mariosgit/freeDSPx-AMP-x4/README.md

# freeDSPx AMP x4

BOARD STATUS: READY TO BE BUILT

MAIN COORDINATOR: [ssMMnn](https://github.com/ssMMnn)

Multichannel Class-D amplification module with digital input, designed for use with the freeDSP. Based on TI's TAS5720M chip. Supports freeDSP standard I2S expansion connector. Supports TDM input format.

[Read the docu...](./freeDSPx%20AMP%20x4.md)

## License

This work and all other materials under https://github.com/freeDSP are licensed under a <a rel="license" href="http://creativecommons.org/licenses/by-sa/4.0/legalcode">Creative Commons Attribution Share-Alike 4.0 license</a>. This allows for both personal and commercial derivative works, as long as they credit freeDSP and release their designs under the same license.
