mariosgit/freeDSPx-AMP-x4/freeDSPx AMP x4.md

# 	

Exported from google docs, vscode md preview does show the embedded images.

# 

**Getting started**   
**with the freeDSPx AMP x4**

**Revision history**

| Revision | Description | Date |
| :---- | :---- | :---- |
| V 1.0 | Initial version | 26 Feb 2017 |
|  |  |  |
|  |  |  |
|  |  |  |

**Table of contents**

[About the freeDSPx AMP x4](#about-the-freedspx-amp-x4)

[Important information](#important-information)

[Overview](#overview)

[Output power](#output-power)

[Digital input](#digital-input)

[LEDs and fault states](#leds-and-fault-states)

[How to get the freeDSPx AMP x4 up and running](#how-to-get-the-freedspx-amp-x4-up-and-running)

[Get everything needed](#get-everything-needed)

[Solder the board](#solder-the-board)

[Setting-up operation](#setting-up-operation)

[Troubleshooting](#troubleshooting)

[Appendix](#appendix)

[Specifications](#specifications)

[Part list](#part-list)

[Assembly print](#assembly-print)

[Schematic](#schematic)

# **About the freeDSPx AMP x4** {#about-the-freedspx-amp-x4}

The freeDSPx AMP x4 is a four channel amplifier module with a digital eight channel TDM input, designed to be used with a freeDSP module. The freeDSPx AMP x4 is a medium power class-D amplifier based on the TAS5720M IC from Texas Instruments and can supply up to 25 Watts with less than 1% THD+N to a 4Ω load per channel. The amplifier directly uses a digital input signal and circumvents an additional digital to analog conversion after the DSP. Overall noise and signal to noise ratio will be improved through that. Two freeDSPx AMP x4 can be stacked to form an eight channel amplifier.

The plans for the freeDSP boards are published under a Creative Commons Attribution Share-Alike 4.0 license, which allows the unrestricted use and modification of the module.  This means that experienced users can make their own version of the module, extending it and improving it, as long as they credit freeDSP and release their designs under the same license. The freeDSP brand and freeDSP logo are copyright of Sebastian Merchel and Ludwig Kormann and cannot be used without formal permission. This getting started guide is published under the same CC license. 

# **Important information**  {#important-information}

Boards from the freeDSP system are provided to you ‘as is’. We make no express or implied warranties whatsoever with respect to its functionality, operability, or use, including, without limitation, any implied warranties of merchantability, fitness for a particular purpose, or infringement. We expressly disclaim any liability whatsoever for any direct, indirect, consequential, incidental or special damages, including, without limitation, lost revenues, lost profits, losses resulting from business interruption or loss of data regardless of the form of action or legal theory under which the liability may be asserted, even if advised of the possibility or likelihood of such damages. Features and specifications might change without prior notice.

**Please keep in mind that freeDSP is an open-source spare-time project.** Because the freeDSP system is very flexible, many applications are possible. Questions and new ideas can be discussed online with other DIYers.  Please use the ‘Digital Line Level’ subforum @ diyAudio.com to connect with other people working with the freeDSP. Please create individual threads for your topics. Link these threads in the [**freeDSP main thread**](http://www.diyaudio.com/forums/digital-line-level/285260-freedsp-main-thread.html) \- so that others can find them. Some questions can be answered by carefully reading this manual. **We cannot provide individual support via email.** Thank you for your understanding\!

# **Overview** {#overview}

Figure 1 shows the key features of the freeDSPx AMP x4 board. 



**Figure 1 \- Overview of the freeDSPx AMP x4 board**

## **Output power** {#output-power}

The maximum output power of the freeDSPx AMP x4 depends on the load impedance and the supply voltage. An increase of the supply voltage up to 18 V will lead to increased output power. Further increase in the supply voltage up to 26,4 V is possible but will not lead to more output power. The output power of the freeDSPx AMP x4 is shown in Table 1\.

**Table 1 – Output power of the freeDSPx AMP x4**

| Power supply  | Load Impedance | Maximum THD+N | Output power |
| :---- | :---- | :---- | :---- |
| 12 V | 4 | 0,1 % | 11,9 W |
| 12 V | 4 | 1 % | 12,6 W |
| 12 V | 8 | 0,1 % | 7,1 W |
| 12 V | 8 | 1 % | 7,4 W |
| 18 V or more | 4 | 0,1 % | 14,0 W |
| 18 V or more | 4 | 1 % | 25,0 W |
| 18 V or more | 8 | 0,1 % | 13,1 W |
| 18 V or more | 8 | 1 % | 13,8 W |

## **Digital input** {#digital-input}

The freeDSPx AMP x4 features an digital eight channel time division multiplexed (TDM) input. The amplifier can use the lower (0-3) or upper (4-7) four slots of a TDM-8 frame as input. The input slots can be selected with the TDM slot jumper. You can use a ribbon cable and crimp multiple connectors on it, to connect two freeDSPx AMP x4 to a single TDM output of a freeDSP and amplify all eight channels. 

For more details on TDM and digital audio communication with the freeDSP system refer to the freeDSP \- serial audio getting started guide.

## **LEDs and fault states**  {#leds-and-fault-states}

The freeDSPx AMP x4 has a green power led (D4) which indicates that the amplifier is powered. The module also has four red fault leds (D5, D6, D7, D8) which indicate a fault state on the closest amplifier IC to the led. Reasons for faults  states can be:

1) no correct digital TDM signal at the input  
2) overtemperature of the amplifier IC  
3) overcurrent or short circuit at the output  
4) over- or undervoltage at the power supply  

When a fault state occurs the amplifier will mute the corresponding output. The output will be automatically unmuted pop-free after the fault state is no longer present.

# **How to get the freeDSPx AMP x4 up and running** {#how-to-get-the-freedspx-amp-x4-up-and-running}

The following steps will guide you through the workflow to get your freeDSPx AMP x4 up and running. 

## **Get everything needed** {#get-everything-needed}

You need all electronic components and a printed circuit board (pcb) to build your freeDSPx AMP x4. A bill of materials for the components is listed at the end of this document. The manufacturing data (gerber) as well as the schematic and layout (KiCAD) for the pcb is available on the freeDSP GitHub. 

If you group together with friends or others and order pbs and components in bulk, you can save money. 

## **Solder the board**  {#solder-the-board}

All surface mounted devices of the freeDSPx AMP x4 have to be soldered in a reflow process. The solder paste should be stencil printed. The manufacturing data for a stencil is also available on the freeDSP GitHub. Keep in mind that the TAS5720M amplifier IC is a fine-pitch component in a QFN package with 0,4 mm pitch and will require sufficient precision in the manufacturing process.

All through hole components of the freeDSPx AMP x4 can be hand soldered after the reflow process.

If you can not reflow solder the amplifier on your own you can order it from a professional manufacturer of your choice. If you group together with others for this and order a larger quantity you can save a lot of money.

## **Setting-up operation** {#setting-up-operation}

The freeDSPx AMP x4 has to be connected to a freeDSP module with a I²S standard connector and a TDM output. A freeDSP Classic DSP with a freeDSPx-Adapter can also be used. The freeDSPx AMP x4 is compatible to a 12.288 MHz or 24.576 MHz masterclock. 

Open the *Hardware Configuration* tab in SigmaStudio. At the bottom of the window, select the *IC 1 \- 170x/140x Register Control* tab. Change the serial output settings according to figure 2 and figure 3 in SigmaStudio. In addition, the GPIO pins MP6, MP10 and MP11 have to be reconfigured to output the relevant signals, as shown in figure 4\.

****

**Figure 2 \- Serial output settings in SigmaStudio**

****

**Figure 3 \- Serial output settings in SigmaStudio**

****

**Figure 4 \- GPIO settings in SigmaStudio**

## **Troubleshooting**  {#troubleshooting}

1. Please take the time to carefully read this getting started guide and have a look at the online application examples. **Please keep in mind that freeDSP system is an open-source spare-time project.** Thank you for your understanding\!  
2. Maybe your issue has already been discussed in the **freeDSP forum**. There might already be a solution for the problem you are facing. Please use the ‘Digital Line Level’ subforum @ diyAudio.com to connect with other people working with the freeDSP. Please create individual threads for your topics. Link these threads in the [**freeDSP main thread**](http://www.diyaudio.com/forums/digital-line-level/285260-freedsp-main-thread.html) \- so that others can find them.  
3. **We cannot provide support via email or the contact form on the website.** We hope that you understand that freeDSP is not a commercial product. It is an **open-source spare-time project**. We hope that questions can be answered together with the freeDSP community in the freeDSP forum. Please be patient and remember that forums work on a voluntary basis.  If you post to a **forum**, please provide:   
   1. The version of the freeDSP board you are working with. A good resolution photo of your soldered board from top and bottom. If you made some changes to the original design, please describe them in detail.  
   2. A detailed and clear explanation of the symptoms you are seeing.  
   3. A description of the troubleshooting steps you already performed and the results obtained.

# **Appendix** {#appendix}

## **Specifications** {#specifications}

**Table 1 \- Specifications of the freeDSPx AMP x4**

| Dimensions | 100 mm x 60 mm x 17 mm |
| :---- | :---- |
| **Power supply** | 4,5 V – 26,4 V DC (screw terminals)  |
| **Power consumption** | 80mA (idle) up to 10A (depending on output power) |

## **Part list**  {#part-list}

All components for the freeDSPx AMP x4 are available at **Mouser Electronics.**

**Table 2 \- Bill of materials for the freeDSPx-Adapter.**

| Part | Description | Qty. | Order number www.mouser.com |
| :---: | :---: | :---: | :---: |
| C11, C12, C23, C24, C35, C36, C47, C48 | Electrolytic capacitor, 100u/35V | 8 | 667-EEU-FC1V101 |
| C13, C14, C25, C26, C37, C38, C49, C50 | Ceramic Capacitor, 220n/25V | 8 | 81-GRM18R71E223KA01J |
| C15, C16, C27, C28, C39, C40, C51, C52 | Ceramic Capacitor, 680n/50V | 8 | 81-GCM31CR71H684KA7L |
| C2 | Ceramic Capacitor, 10u/35V | 1 | 81-GRM319R6YA106KA2D |
| C1, C10, C21, C22, C3, C33, C34, C45, C46, C9 | Ceramic Capacitor, 100n/50V | 10 | 81-GRM39X104K50D |
| C4 | Ceramic Capacitor, 22u/10V | 1 | 81-GRM31CR70J226KE9L |
| C17, C18, C19, C20, C29, C30, C31, C32, C41, C42, C43, C44, C5, C6, C7, C8 | Ceramic Capacitor, 1u/16V | 16 | 81-GRM188R71C105KE5D |
| D1 | Shottky diode, SBR10E45P5 | 1 | 621-SBR10E45P5-7 |
| D2 | TVS diode, 5.0SMDJ28CA | 1 | 576-5.0SMDJ28CA |
| D3 | Shottky diode, PMEG6010ER | 1 | 771-PMEG6010ER115 |
| D4 | LED green | 1 | 710-150060GS75000 |
| D5, D6, D7, D8 | LED red | 4 | 710-150060RS75000 |
| FB1 | Ferrite bead 470 | 1 | 81-BLM18PG471SN1D |
| FB2 | Ferrite bead 115 | 1 | 875-28F0181-1SR-10 |
| JP1 | Pin header, 1x2, 2.54 mm pitch | 1 | 571-826646-2 |
| L1 | Inductor, 47u | 1 | 80-L1207C470KPWST |
| L2, L3, L4, L5, L6, L7, L8, L9 | Inductor, 15u | 8 | 81-1264EY-150MP3 |
| P1, P3, P4, P5, P6 | Terminal, 2x, 5.08mm pitch | 5 | 571-796911-2 |
| P2 | Box header, 2x8, 2.54mm pitch | 1 | 710-61201621621 |
| R1 | Resistor, 1.2kΩ | 1 | 71-CRCW0603-1.02K-E3 |
| R2 | Resistor, 3.4kΩ | 1 | 71-CRCW0603-3.4K-E3 |
| R14, R19, R3, R4, R9 | Resistor, 620Ω | 5 | 71-CRCW0603-620-E3 |
| R10, R12, R15, R17, R20, R22, R5, R6 | Resistor, 2.4kΩ | 8 | 71-CRCW0603-2.4K-E3 |
| R11, R16, R21, R7 | Resistor, 100kΩ | 4 | 71-CRCW0603-100K-E3 |
| R13, R18, R8 | Resistor, 22kΩ | 3 | 71-CRCW0603-22K-E3 |
| RP1 | Resistor, 33Ω | 1 | 652-CAY16-330J4LF |
| U1 | LM2841X Buck converter | 1 | 926-M2841XMKADJLNOPB |
| U2, U3, U4, U5 | TAS5720M Amplifier IC | 4 | 595-TAS5720MRSMT |

A preconfigured shopping basket is also available:  
[Mouser Electronics basket for the freeDSPx AMP x4](https://www.mouser.de/ProjectManager/ProjectDetail.aspx?AccessID=af1cc43262)  

## **Assembly print** {#assembly-print}

  
**Figure 4 \- Board silkscreen and part placement for freeDSPx AMP x4**

## **Schematic** {#schematic}

The schematic of the freeDSPx AMP x4 is available on the freeDSP GitHub as a PDF or KiCad project.

[image1]: <>

[image2]: <>

[image3]: <>

[image4]: <>

[image5]: <>
