mariosgit/freeDSPx-AMP-x4/SOURCES/Kicad/Amp_IC-A.kicad_sch

## KiCad design SOURCES/Kicad/Amp_IC-A.kicad_sch (2024-09-09)

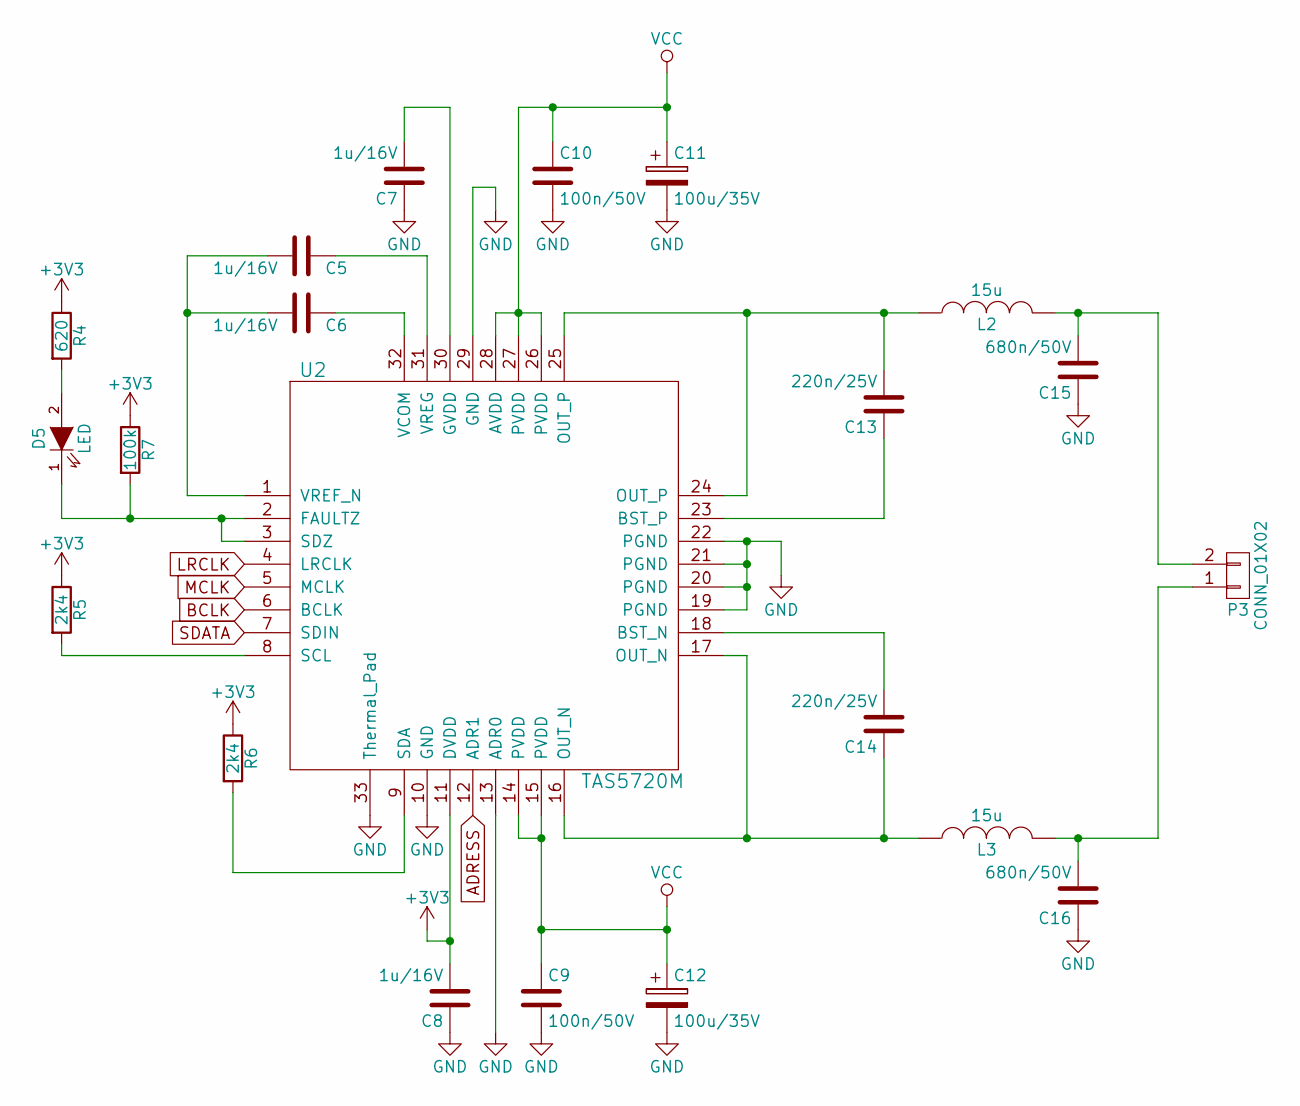
[picture p1: schematic Amp_IC-A.kicad_sch]

Parts:
C5, C6, C7, C8: 1u/16V; C_0603; Mouser_Part_No 81-GRM188R71C105KE5D
C9, C10: 100n/50V; C_0603; Mouser_Part_No 81-GRM39X104K50D
C11, C12: 100u/35V; C_Radial_D8_L11.5_P3.5; Mouser_Part_No 667-EEU-FC1V101
C13, C14: 220n/25V; C_0603; Mouser_Part_No 81-GRM18R71E223KA01J
C15, C16: 680n/50V; C_1206; Mouser_Part_No 81-GCM31CR71H684KA7L
D5: LED; C_0603; Mouser_Part_No 710-150080RS75000
L2, L3: 15u; Choke_SMD_6.0x6.0; Mouser_Part_No 81-1264EY-150MP3
P3: CONN_01X02; RIACON101-2; Mouser_Part_No 571-796911-2
R4: 620; R_0603; Mouser_Part_No 71-CRCW0603-620-E3
R5, R6: 2k4; R_0603; Mouser_Part_No 71-CRCW0603-2.4K-E3
R7: 100k; R_0603; Mouser_Part_No 71-CRCW0603-100K-E3
U2: TAS5720M; VQFN-32-handsolder; Mouser_Part_No 595-TAS5720MRSMT

Connections:
+3V3: C8.2, R4.1, R5.1, R6.1, R7.1, U2.11 (DVDD)
ADRESS: U2.12 (ADR1)
BCLK: U2.6 (BCLK)
GND: C7.1, C8.1, C9.2, C10.2, C11.2, C12.2, C15.1, C16.1, U2.10 (GND), U2.13 (ADR0), U2.19 (PGND), U2.20 (PGND), U2.21 (PGND), U2.22 (PGND), U2.29 (GND), U2.33 (Thermal_Pad)
LRCLK: U2.4 (LRCLK)
MCLK: U2.5 (MCLK)
unnamed: C5.1, U2.31 (VREG)
unnamed: C5.2, C6.2, U2.1 (VREF_N)
unnamed: C6.1, U2.32 (VCOM)
unnamed: C7.2, U2.30 (GVDD)
unnamed: C13.1, U2.23 (BST_P)
unnamed: C13.2, L2.1, U2.24 (OUT_P), U2.25 (OUT_P)
unnamed: C14.1, L3.1, U2.16 (OUT_N), U2.17 (OUT_N)
unnamed: C14.2, U2.18 (BST_N)
unnamed: C15.2, L2.2, P3.2
unnamed: C16.2, L3.2, P3.1
unnamed: D5.1 (K), R7.2, U2.2 (FAULTZ), U2.3 (SDZ)
unnamed: D5.2 (A), R4.2
unnamed: R5.2, U2.8 (SCL)
unnamed: R6.2, U2.9 (SDA)
SDATA: U2.7 (SDIN)
VCC: C9.1, C10.1, C11.1, C12.1, U2.14 (PVDD), U2.15 (PVDD), U2.26 (PVDD), U2.27 (PVDD), U2.28 (AVDD)
