mariosgit/freeDSPx-AMP-x4/SOURCES/Kicad/Amp_IC-C.kicad_sch

## KiCad design SOURCES/Kicad/Amp_IC-C.kicad_sch (2024-09-09)

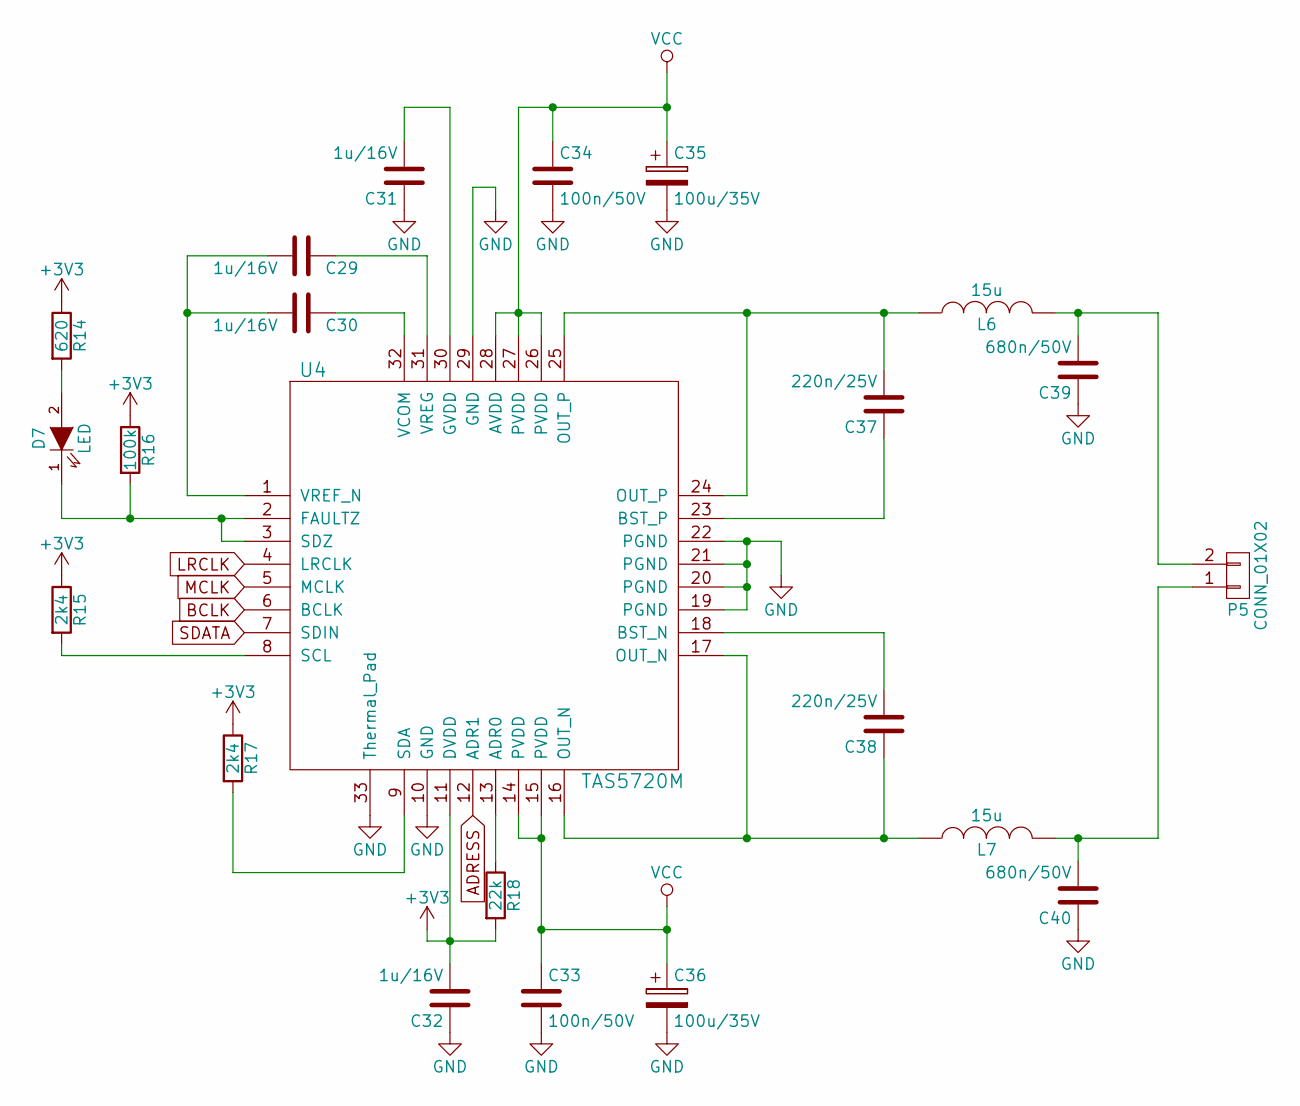
[picture p3: schematic Amp_IC-C.kicad_sch]

Parts:
C29, C30, C31, C32: 1u/16V; C_0603; Mouser_Part_No 81-GRM188R71C105KE5D
C33, C34: 100n/50V; C_0603; Mouser_Part_No 81-GRM39X104K50D
C35, C36: 100u/35V; C_Radial_D8_L11.5_P3.5; Mouser_Part_No 667-EEU-FC1V101
C37, C38: 220n/25V; C_0603; Mouser_Part_No 81-GRM18R71E223KA01J
C39, C40: 680n/50V; C_1206; Mouser_Part_No 81-GCM31CR71H684KA7L
D7: LED; C_0603; Mouser_Part_No 710-150080RS75000
L6, L7: 15u; Choke_SMD_6.0x6.0; Mouser_Part_No 81-1264EY-150MP3
P5: CONN_01X02; RIACON101-2; Mouser_Part_No 571-796911-2
R14: 620; R_0603; Mouser_Part_No 71-CRCW0603-620-E3
R15, R17: 2k4; R_0603; Mouser_Part_No 71-CRCW0603-2.4K-E3
R16: 100k; R_0603; Mouser_Part_No 71-CRCW0603-100K-E3
R18: 22k; R_0603; Mouser_Part_No 71-CRCW0603-22K-E3
U4: TAS5720M; VQFN-32-handsolder; Mouser_Part_No 595-TAS5720MRSMT

Connections:
+3V3: C32.2, R14.1, R15.1, R16.1, R17.1, R18.2, U4.11 (DVDD)
ADRESS: U4.12 (ADR1)
BCLK: U4.6 (BCLK)
GND: C31.1, C32.1, C33.2, C34.2, C35.2, C36.2, C39.1, C40.1, U4.10 (GND), U4.19 (PGND), U4.20 (PGND), U4.21 (PGND), U4.22 (PGND), U4.29 (GND), U4.33 (Thermal_Pad)
LRCLK: U4.4 (LRCLK)
MCLK: U4.5 (MCLK)
unnamed: C29.1, U4.31 (VREG)
unnamed: C29.2, C30.2, U4.1 (VREF_N)
unnamed: C30.1, U4.32 (VCOM)
unnamed: C31.2, U4.30 (GVDD)
unnamed: C37.1, U4.23 (BST_P)
unnamed: C37.2, L6.1, U4.24 (OUT_P), U4.25 (OUT_P)
unnamed: C38.1, L7.1, U4.16 (OUT_N), U4.17 (OUT_N)
unnamed: C38.2, U4.18 (BST_N)
unnamed: C39.2, L6.2, P5.2
unnamed: C40.2, L7.2, P5.1
unnamed: D7.1 (K), R16.2, U4.2 (FAULTZ), U4.3 (SDZ)
unnamed: D7.2 (A), R14.2
unnamed: R15.2, U4.8 (SCL)
unnamed: R17.2, U4.9 (SDA)
unnamed: R18.1, U4.13 (ADR0)
SDATA: U4.7 (SDIN)
VCC: C33.1, C34.1, C35.1, C36.1, U4.14 (PVDD), U4.15 (PVDD), U4.26 (PVDD), U4.27 (PVDD), U4.28 (AVDD)
