mariosgit/freeDSPx-AMP-x4/(commit log)

2024-09-09 Changed VQFN footprint to solderable.
    [Amp_IC-A.kicad_sch, Amp_IC-B.kicad_sch, Amp_IC-C.kicad_sch, Amp_IC-D.kicad_sch, freeDSPx-AMPx4.kicad_pcb, freeDSPx-AMPx4.kicad_sch]
2024-09-12 Changed heat disipation Vias to a big one to solder through.
    [freeDSPx-AMPx4.kicad_pcb]
